schvvalbe/wifi-led-controller/CHANGELOG.md

# [1.2.1] - 2026-11-01

### Изменения

#### Управление подсветкой

  - Реализованы автоматический и ручной режимы RGB-подсветки. Команда включения или выключения из интерфейса переводит контроллер в ручной режим.
  - В автоматическом режиме любой из двух датчиков движения включает свет и продлевает таймер. Время после последнего движения настраивается от 1 до 3600 секунд; учёт освещённости можно отключить или задать порог срабатывания.
  - Добавлены выбор RGB-цвета, готовые цвета, яркость от 0 до 100% и раздельная настройка плавного включения и выключения от 0 до 10 секунд. Изменение команды во время перехода продолжает регулирование с текущей яркости.
  - При запуске подсветка остаётся выключенной; автоматическое управление начинает учитывать движение после 30 секунд прогрева датчиков.

#### Подключение Wi-Fi

  - Добавлены поиск сетей 2,4 ГГц, ручной ввод SSID и подключение к скрытым и открытым сетям.
  - При отсутствии настроенной сети контроллер открывает точку доступа `PhysTechLab-XXXXXX` с интерфейсом настройки по адресу `192.168.4.1`. Поддерживаются восстановление соединения и локальное имя mDNS.
  - Новые данные Wi-Fi сохраняются после успешной проверки подключения. При неудаче прежние данные остаются доступными; сеть настройки работает во время проверки и ещё минуту после успешного подключения.

#### Веб-интерфейс

  - Добавлен адаптивный интерфейс на русском языке для компьютеров и телефонов с локальными ресурсами, встроенными в прошивку. Для управления не требуются облако и доступ в интернет.
  - Реализованы светлая, тёмная и системная темы с сохранением выбора в браузере, а также добавление ярлыка контроллера на главный экран или рабочий стол.
  - Отображаются состояние света и датчиков, оставшееся время работы, прогрев, сохранение настроек, подключение Wi-Fi, адрес устройства, уровень сигнала и версия прошивки.
  - Форма Wi-Fi сохраняет введённые данные при обновлении статуса. Периодический опрос не перезаписывает неизменившиеся элементы формы и не переоткрывает свёрнутые настройки. «Далее» переводит к паролю, «Готово» закрывает клавиатуру; подключение запускается отдельной кнопкой.
  - При потере связи интерфейс показывает недоступность устройства и блокирует команды. В защищённом контексте поддерживается офлайн-оболочка; команды, состояния устройства и пароли не кэшируются и не отправляются автоматически после восстановления сети.

#### Хранение настроек

  - Параметры света, автоматики и Wi-Fi сохраняются в LittleFS с отложенной записью, проверкой временного файла и резервной копией конфигурации.
  - После перезапуска восстанавливаются сохранённые параметры. Ошибки записи отображаются в интерфейсе; некорректные значения и неизвестные поля запросов отклоняются.

#### Обновление прошивки

  - Добавлено обновление по Wi-Fi через браузер, командную строку и задачи VS Code с сохранением настроек.
  - Реализованы пароль обновления, проверка размера и формата образа, контрольной суммы MD5 и полноты передачи, отображение прогресса и автоматическая перезагрузка после успешной записи.
  - На время обновления подсветка выключается. При обрыве связи файл не отправляется повторно автоматически; сборка проверяет запас Flash для следующего OTA-обновления.

#### Система

  - Добавлена перезагрузка из интерфейса с сохранением применённых настроек перед перезапуском.
  - Добавлен полный сброс с очисткой раздела настроек, включая резервные и временные файлы, и конфигурации Wi-Fi SDK. После перезапуска устройство возвращается в режим настройки сети.
  - Перезагрузка и сброс требуют подтверждения; во время обновления прошивки, подключения и поиска Wi-Fi системные команды недоступны.

#### Сборка и разработка

  - Создан проект PlatformIO для ESP8266 / ESP-07 с профилями загрузки по USB–TTL и Wi-Fi, закреплёнными зависимостями и автоматическим встраиванием веб-интерфейса в образ прошивки.
  - Добавлены задачи VS Code и инструкции по сборке, подключению платы, первой записи и последующим OTA-обновлениям.
  - Добавлены автоматизированные проверки логики подсветки, подключения Wi-Fi, хранения и сброса настроек, загрузки прошивки и браузерного интерфейса в Chromium и WebKit.
  - Настроен GitHub Actions: проверки прошивки и тесты при pull request в дефолтную ветку, сборка BIN/ZIP и публикация релиза после слияния с версией из FirmwareInfo.h и заметками из CHANGELOG.md.
