schvvalbe/wifi-led-controller/docs/main_board.pdf

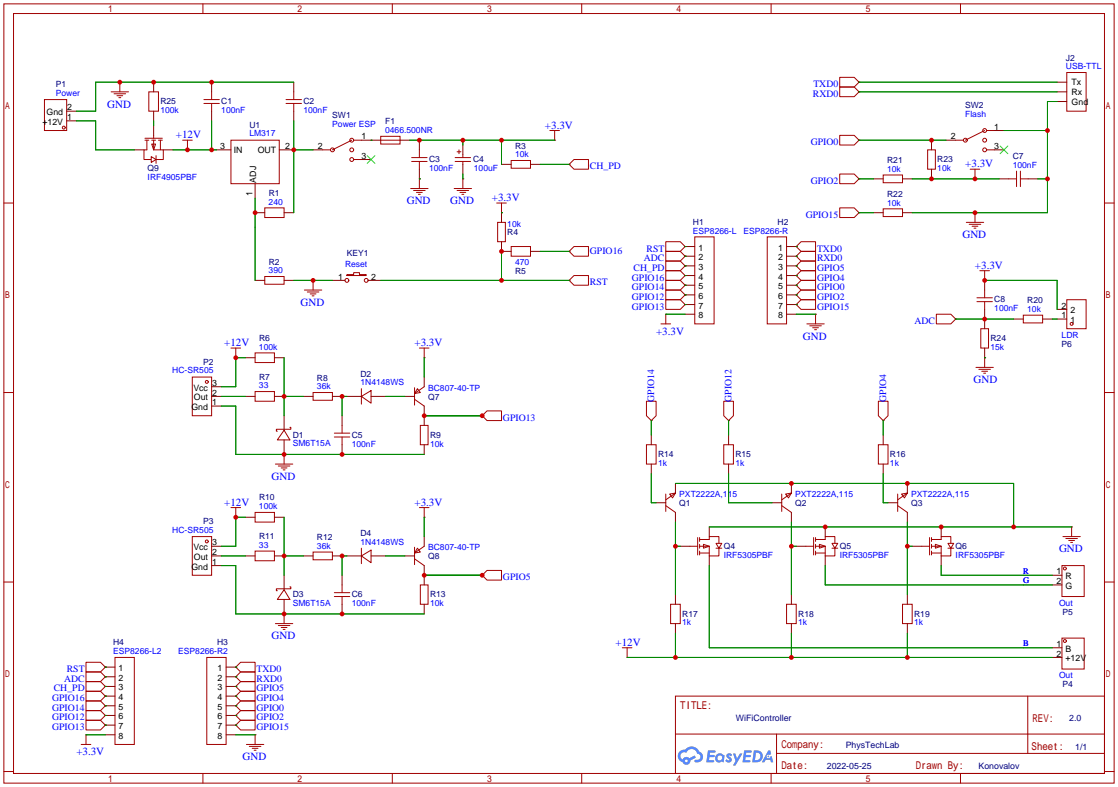
[picture p3: page 1]
