schvvalbe/wifi-led-controller/docs/pir_sensor_invertor.pdf

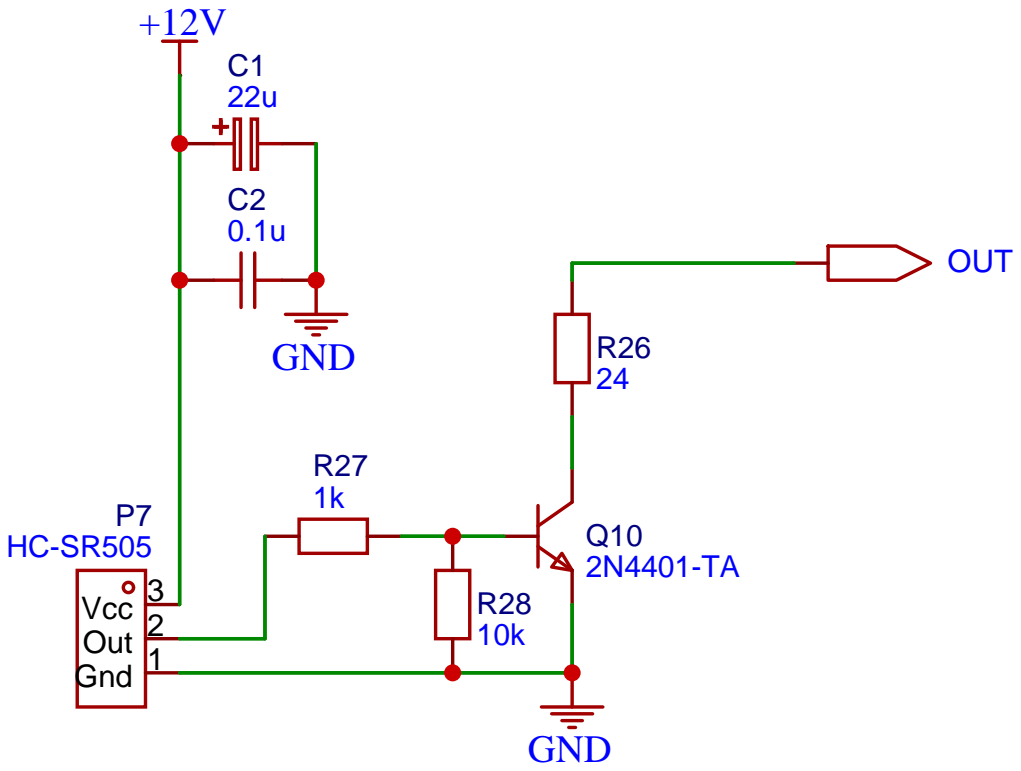
[picture p4: page 1]
