schvvalbe/wifi-led-controller/(list of files, drawings)

Other design files:
easyeda/WiFiController.epro
