schvvalbe/wifi-led-controller/include/FirmwareInfo.h

#pragma once

namespace Firmware {
constexpr char Version[] = "1.2.1";
// Change before building if the controller is on a shared local network.
constexpr char OtaPassword[] = "wifi-led-controller";
}
