schvvalbe/wifi-led-controller/(commit log)

2026-11-01 Обновлена документация
    [WiFiController.epro]
2026-11-01 Первая версия github ci
